Jaycar-Electronics/Portable-Soil-Moisture-Meter/images/IMAG0334.jpg

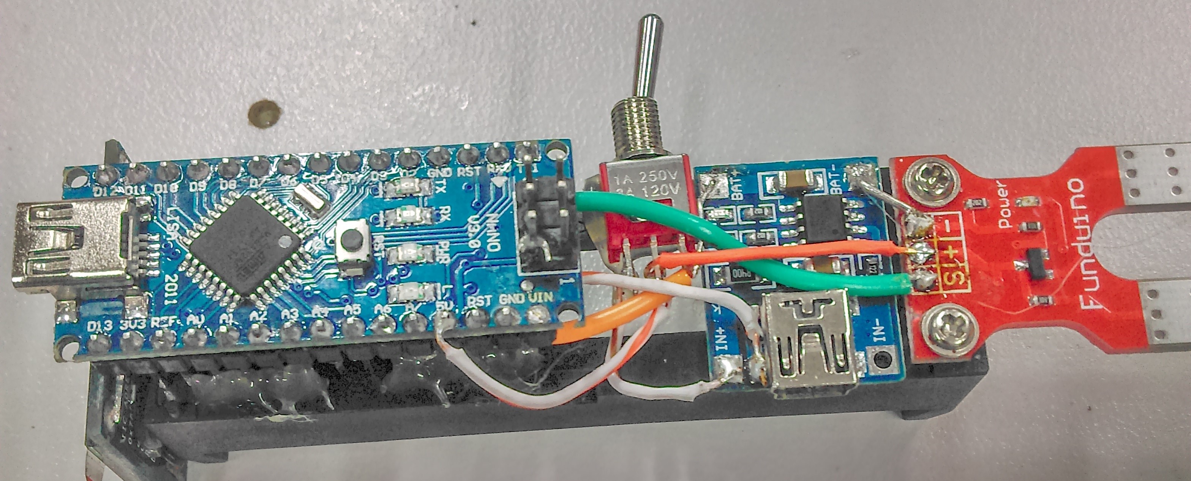
images/IMAG0334.jpg
